KubaO/sdo-kicad-libs/README.md

# sdo-kicad-libs
Sunderland-Ober KiCad Libraries Shared Across Projects
