KubaO/sdo-kicad-libs/(commit log)

2022-11-19 Add ULN2003 matched diodes application.
2022-12-14 Fix some of the CD4xxx symbol pin lengths and output vs. tri-state type.
2022-12-26 Fix footprints and datasheets.
2023-04-20 Add D6D-q12, C&K MP01R123CBE switches.
2023-04-26 Add 3V power and ADJUST symbols.
2023-04-29 Add C&K 7010P3YZBE switch.
2023-04-29 Add 1500µF/6.3V, 33µF/25V and 680µF/6.3V radial capacitors.
2023-04-29 Add 1N4148, 1N5817 diodes.
2023-04-29 Narrow transistor footprint paths, add generic datasheet paths.
2023-04-29 Add 2N3904, 2N3906, KT814Б transistors.
2023-04-29 Add new axial resistors, derive resistors from base symbols.
2023-04-29 Add Bourns multi-potentiometer footprints.
2023-04-30 Add top&bottom-labeled SolderWire footprints.
2023-04-30 Add signal labels to the PCBEdge_18 connector.
2023-05-12 Add new stock resistors.
2023-05-12 Add two-sided silkscreen variants of some through-hole components.
2023-05-12 Add compact wire-connected parts.
2023-05-24 Add TO-92 footprints. Add DIP chip to the socket footprint.
2023-05-24 Add 100k stock resistor.
2023-08-23 Change Deltron banana receptacle pin 1 to rounded rectangle for fit.
2023-08-23 Add C&K 7103MD9AV2BE switch.
2023-08-23 Add Bourns 3006P-Z potentiometer footprint.
2023-08-23 Add various JST XH connector footprints.
2023-08-23 Add 5mm horizontal LED footprint.
2023-08-23 Add Harvatek 3mm horizontal LED footprint.
2023-08-23 Add XKB DC-002-2.0A-1.0 connector footprint.
2023-08-24 Add C&K 7203MD9AV2BE switch.
2023-08-24 Add datasheet to the C&K 7103MD9AV2BE switch.
2025-06-20 Add an alternative footprint for Bourns 3006P-Z.
2025-06-20 Update COTO 9001 relay 3D model paths.
2025-06-20 Change the pad geometry of the HE3321C1200 relay.
2025-06-20 Add a generic symbol for the DIN C 36-pin connector.
2025-06-20 Add 3mm Harvatek indicators, and HE722A0500 relay footprint.
2025-06-20 Add 3mm KingBright indicator datasheet and model.
2025-06-20 Add pin function fields and legend to the DIN41612 C connector, HE722A0500, HE3321C1200, COTO 9001.
2025-06-20 Update the 3mm Harvatek indictor.
2025-06-20 Add 2-deep relative 3D model directories to all footprints.
2025-06-20 Add bottom reference and legend to COTO 9001, 9002 and TTI TRA-1050R relays.
2025-06-20 Add 2-deep 3D model directories and bottom references to the rest of the relays.
2025-06-20 Fix legend orientation on the DIN41612-C connector.
2025-07-23 Make the MR62 relay footprint self-aligning.
2025-07-28 Add MR62-12 relay.
2025-07-31 Add more Dialight series 571 indicators; Add 1N5819WS diode.
2025-08-17 Add 12- and 22-wide 3.96mm/0.156in pitch edge connectors
2025-08-17 Add TE 5554923 Centronics-style connector.
